AhmedEl-Nagar201/stm32_ThingSpeak_AirQulaity/Schematic_PCB/SmartMonitor.kicad_sch

## KiCad design Schematic_PCB/SmartMonitor.kicad_sch (2026-05-18)

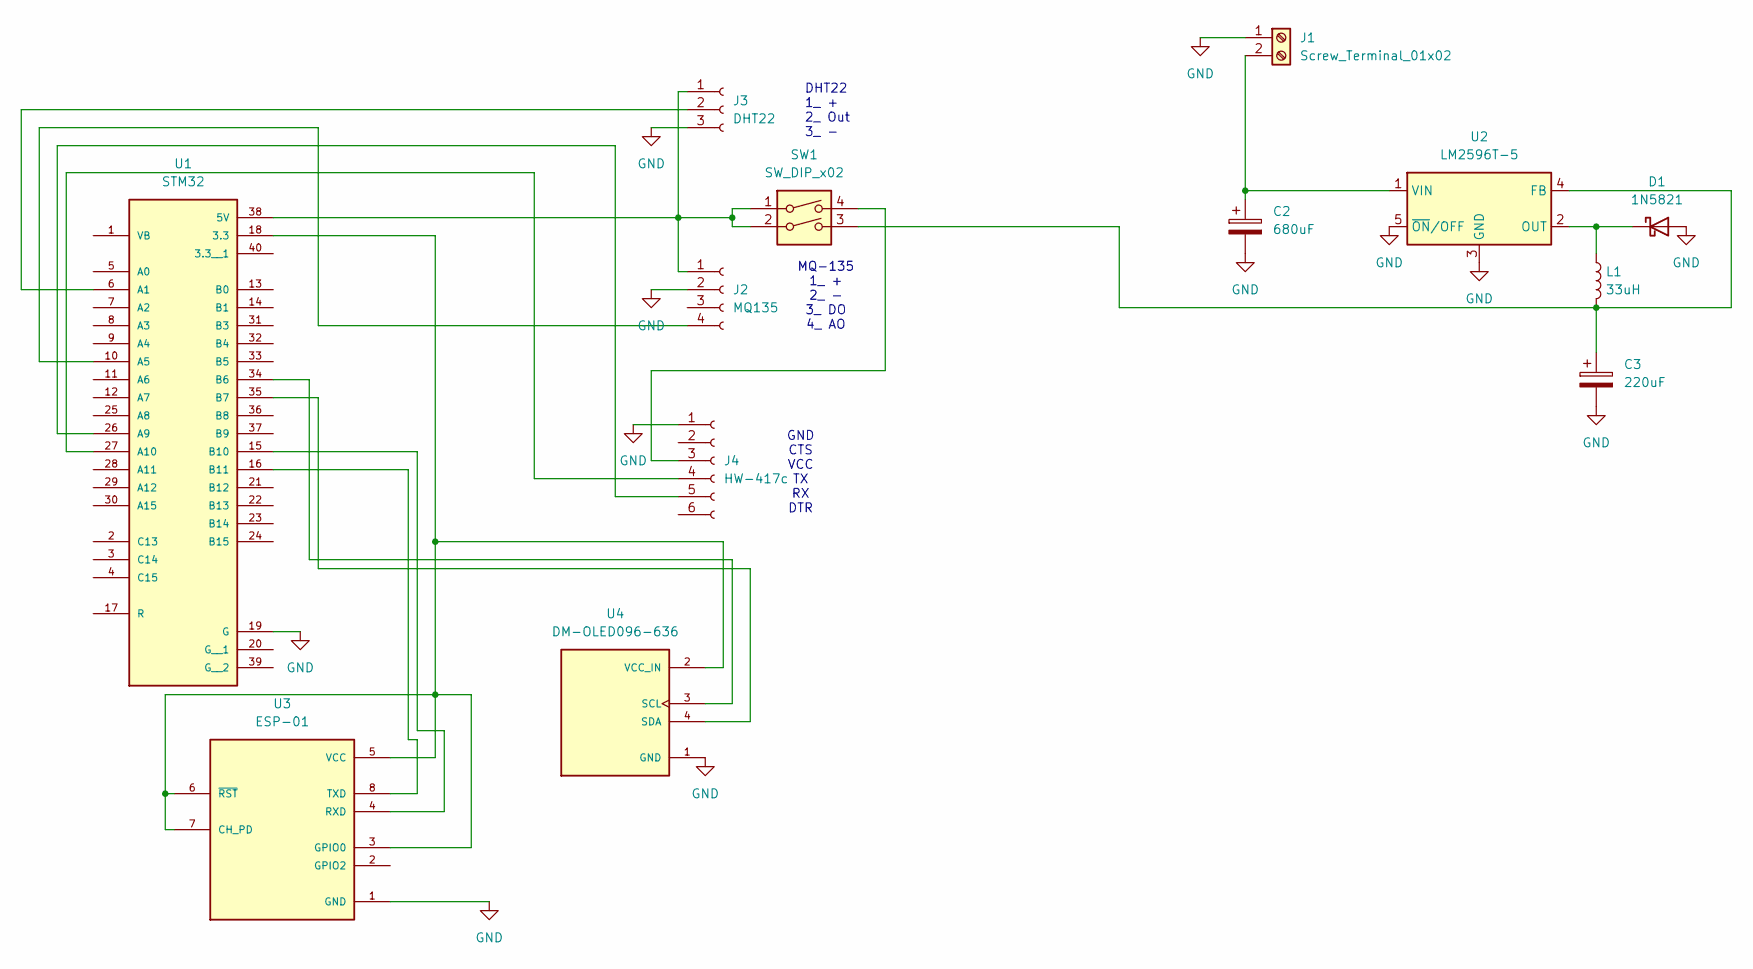
[picture p1: schematic SmartMonitor.kicad_sch]

Parts:
C2: 680uF
C3: 220uF
D1: 1N5821; D_DO-201AD_P15.24mm_Horizontal
J1: Screw_Terminal_01x02
J2: MQ135
J3: DHT22
J4: HW-417c
L1: 33uH
SW1: SW_DIP_x02
U1: STM32; MODULE_ZC323000; PARTREV N/A
U2: LM2596T-5; TO-220-5_P3.4x3.7mm_StaggerOdd_Lead3.8mm_Vertical
U3: ESP-01; MODULE_ESP-01; PARTREV 1.0
U4: DM-OLED096-636; MODULE_DM-OLED096-636; PARTREV 2018-09-10

Connections:
GND: C2.2, C3.2, D1.2 (A), J1.1, J2.2, J3.3, J4.1, U1.19 (G), U2.3 (GND), U2.5 (~ON/OFF), U3.1 (GND), U4.1 (GND)
unnamed: C2.1, J1.2, U2.1 (VIN)
unnamed: C3.1, L1.2, SW1.3, U2.4 (FB)
unnamed: D1.1 (K), L1.1, U2.2 (OUT)
unnamed: J2.1, J3.1, SW1.1, SW1.2, U1.38 (5V)
unnamed: J2.4, U1.10 (A5)
unnamed: J3.2, U1.6 (A1)
unnamed: J4.3, SW1.4
unnamed: J4.4, U1.27 (A10)
unnamed: J4.5, U1.26 (A9)
unnamed: U1.15 (B10), U3.4 (RXD)
unnamed: U1.16 (B11), U3.8 (TXD)
unnamed: U1.18 (3.3), U3.3 (GPIO0), U3.5 (VCC), U3.6 (~RST), U3.7 (CH_PD), U4.2 (VCC_IN)
unnamed: U1.34 (B6), U4.3 (SCL)
unnamed: U1.35 (B7), U4.4 (SDA)

Notes on the sheet:
MQ-135 1_ + 2_ - 3_ DO 4_ AO
DHT22 1_ + 2_ Out 3_ -
GND CTS VCC TX RX DTR
