AhmedEl-Nagar201/stm32_ThingSpeak_AirQulaity/(commit log)

2026-05-15 Hello World
    [SmartMonitor.kicad_pcb, SmartMonitor.kicad_sch]
2026-05-15 Title: Add comprehensive academic README documentation for STM32F103C8T6 air quality monitoring system
    Key features implemented:
    - New README.md file providing detailed technical documentation covering STM32F103C8T6 sensor node implementation with MQ135 and DHT22 integration
    - Complete system architecture overview including ESP-01 bridge firmware and ESP32-S3 gateway communication protocols
    - Academic-level explanation of sensor interface design with code snippets from main.c, dht22.c, mq135.c, and ssd1306.c implementations
    - Detailed packet transmission workflow documenting UART communication, ESP-NOW protocol, and ThingSpeak cloud integration
    - Hardware specifications, power management con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
2026-05-15 don't track .gitignore
2026-05-18 Before RTOS
    [SmartMonitor.kicad_pcb, SmartMonitor.kicad_sch]
