AhmedEl-Nagar201/stm32_ThingSpeak_AirQulaity/(notices)

Notices in the files:
Embedded_Trial/Core/Src/main.c:
Copyright (c) 2026 STMicroelectronics.
All rights reserved.
This software is licensed under terms that can be found in the LICENSE file
